brsunagad/visible-light-communication/Pictures/receiever_image.jpeg

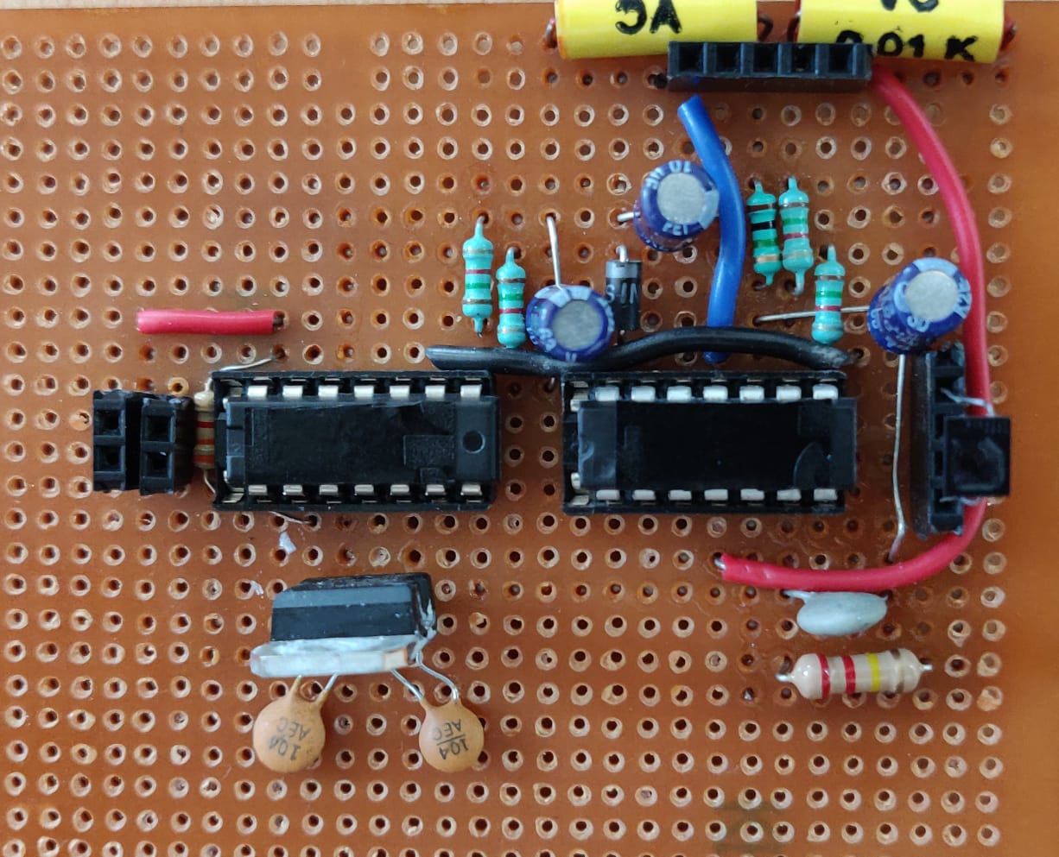
Pictures/receiever_image.jpeg
