brsunagad/visible-light-communication/Pictures/labeled_receiver.jpg

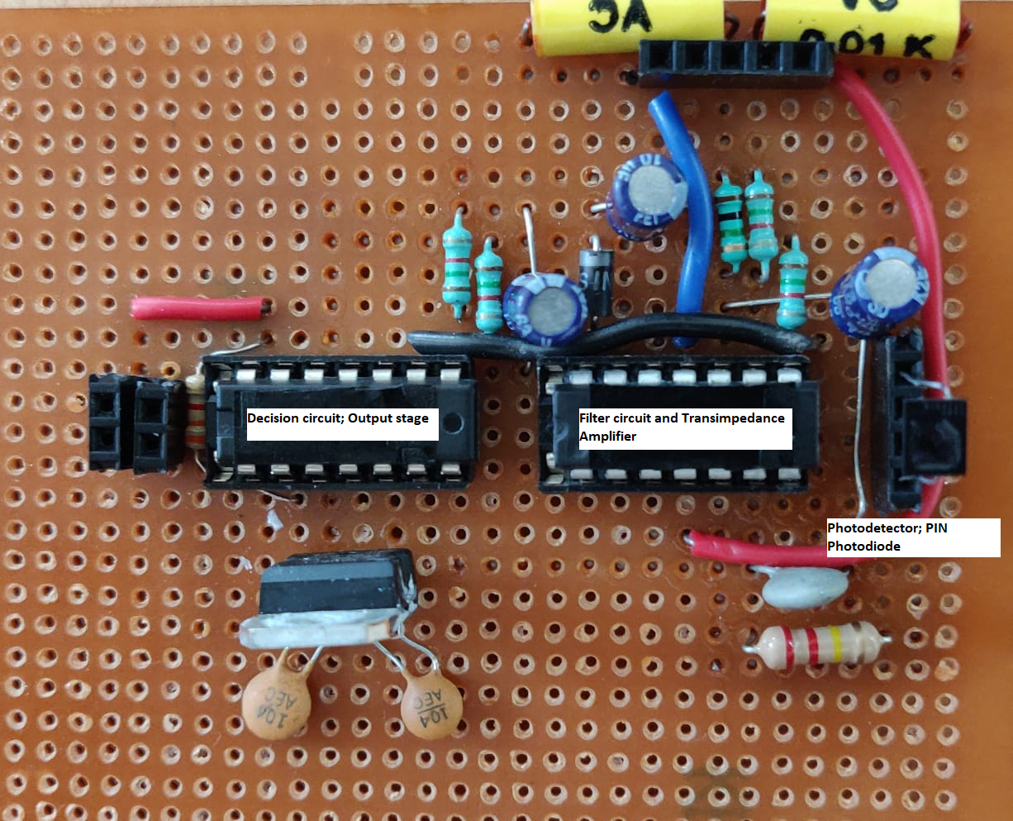
Pictures/labeled_receiver.jpg
