brsunagad/visible-light-communication/paper.pdf

IETE Journal of Research. | 1

Manav Gurumoorthy*

, Basavaraj R Sunagad$
, Ashwin Telagimathada Ravi#

, Akhilesh C Guddad^
and Rohini
Nagapadma&

Manav Gurumoorthy, Basavaraj R Sunagad, Ashwin Telagimathada Ravi and Akhilesh C Guddad are with the department of Electronics and Communication Engineering at The National Institute of Engineering, Mysuru. (* manav.gurumoorthy@gmail.com,

$
brsunagad@gmail.com ,
ashwintr303@gmail.com,
^
akhileshguddad@gmail.com )
Rohini Nagapadma is Professor in the department of Electronics and Communication Engineering at The National Institute of Engineering, Mysuru. (& rohini_nagapadma@nie.ac.in )

ABSTRACT
As conventional communication techniques are reaching its limit in terms of bandwidth, there is a need to explore ways which can overcome the limitations of the current communication techniques. In most cases, the limiting factor for high data rates tends to be the bandwidth of the system. Significant research efforts have been made towards eliminating this drawback of traditional systems while not causing any degradation in the quality of service. This has led to exploring the unused regions of the electromagnetic spectrum to make the switch from RF spectrum and its limited bandwidth. Visible light as a medium of communication is an ideal candidate due to its seemingly infinite bandwidth. Such a method of communication where visible light itself is a medium for data transfer is called Visible Light Communication (VLC). Our research demonstrates the same.

Keywords:
Analog frontend circuit, LED, LTSpice, Manchester encoding, Micro-controller, MOSFET, Photodiode, Serial communication, TIA, VLC.

### 1. INTRODUCTION

The visible light spectrum is the portion of the electromagnetic spectrum that is visible to the human eye. Electromagnetic radiation in this range of wavelengths is called visible light or simply light. A typical human eye will respond to wavelengths from about 390 to 700 nanometers. In terms of frequency, this corresponds to a band in the vicinity of 430–770 THz (Tera-hertz).
Visible light communication is a method of data transfer using visible light spectrum. The visible light spectrum has a bandwidth spanning 100s of THz which is 10000 times larger than the RF bandwidth.
VLC has numerous advantages over conventional methods, such as higher data rates, larger bandwidth, higher security, lower power consumption. Experiments done in VLC have achieved a data rate of 1Gbps under laboratory conditions. By using visible light, it is intended to achieve wireless communication in environments where it is not convenient to use Radio Frequency(RF) waves like in airplanes, hospitals etc. [4].
In VLC, the light source is typically a Light Emitting Diode (LED). Here LEDs are used for data transmission and offers illumination simultaneously. The main principle of this communication system is to switch ON and switch OFF a light source at a high rate, where the ON and OFF states of the light represent binary 1 and binary 0 respectively. By making the switching rate higher than the persistence of vision for humans, the light appears to be continuous in nature. Due to this continuous switching the overall brightness of the light decreases. The receiver works by looking out for the rapid changes of the light that represent data, thereby creating a line of sight communication link between the transmitter and the receiver.
VLC can potentially have a very large bandwidth but it is plagued by certain limitations owing to its physical components. At the transmitter, a white LED is used as a source of light. The limitation in bandwidth arises by the method in which the LED produces white light. At the receiver, the photodiode contains parasitic capacitances which limit the bandwidth of the VLC system. Ambient light interference introduces noise in the channel which affects system performance. The operating range is further limited by sensitivity of the photodiode.
Having studied and understood the capabilities and limitations behind this technology, our research attempts to build a functional visible light communication system to allow basic data transmission between two communicating nodes.

# Visible Light Communication Based File Delivery System

### 2.APPROACH

In our approach to implement a VLC system, we have established communication between two computers. The basic principle is that the transmitter side is made to drive an LED connected to one of the digital output pins of the arduino. The LED toggles ON and OFF based on the pulse received from the digital pin. The receiver uses a photodiode in reverse bias which produces current variations proportional to the received signal. These variations in current need to be further processed to obtain digital voltage signals that represent the data being transmitted.

### 2.1 Transmitter

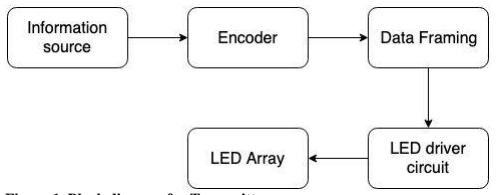
[picture p30: figure]

Figure 1. Block diagram for Transmitter.

2.1.1 Transmitter Software
For the transmitter, feeding in serialized data isn't an ideal way to send the data across the visible light channel. This is because typically data consists of HIGH (1) and LOW (0) bits in which the number of 0s maybe higher. This causes two problems: the first is that due to an increase in the number of transitions in the state of the led, there is a discernable flicker from the source which is not desirable; secondly, the overall brightness of the source drops below 50% as the time that the LED is ON is less than half of the total time. An encoding format is used to overcome the same. A modest way to encode the data is to use Manchester encoding, in which each data bit is encoded as a transition from low to high, or high to low, for an equal duration of time. Here a bit valued „1‟ is encoded as a signal going from HIGH state to LOW state and a „0‟ is encoded to a signal going from LOW state to HIGH state. The Manchester encoded data prevents the reception of consecutive 0s. As a result, the LED brightness is not adversely affected. The encoding scheme used also helps reduce flickering and it is not visible to the naked eye.
Since we use asynchronous serial communication, framing is essential for reliable communication. Framing typically involves the addition of two special flags called delimiters that are added to the start and the end of a data segment. In our implementation we have used 0x03 and 0x02 for the start and stop bits respectively. Additionally, asynchronous communication requires data synchronization between the sender and receiver and this is achieved by a synchronization byte 0xD5 [1].
In order to transfer files from a computer to the microcontroller, a software overlay is needed to read from the file and push the data onto the Arduino through an RS232 interface. Probing into the possible solutions has resulted in exploring multiple programming language options including

C++, python, java and C# and softwares including MATLAB, Processing and Microsoft Visual Studio. The selection of software depends on the trade-off between speed, efficiency and ease of use. While python offers diverse ready to use APIs, C++ promises speed and ease of bit manipulation. Similarly, reading various files from the computer proves to be easier on C# (run on Visual Studio) than on Processing (based on Java).

2.1.2 Transmitter Hardware
The principle of data transmission in VLC is to turn ON and turn OFF a light source in correspondence to the transmitted bits. The transmitter in our system consists of a high power white LED (12 Watts) and a MOSFET switch. This is interfaced to a computer (data source) using an Arduino Uno board that provides the RS-232 interface. Data from the computer is sent to the arduino through UART where it is processed and encoded. The processed data is sent to the driver circuit through a digital output pin in the form of bits.

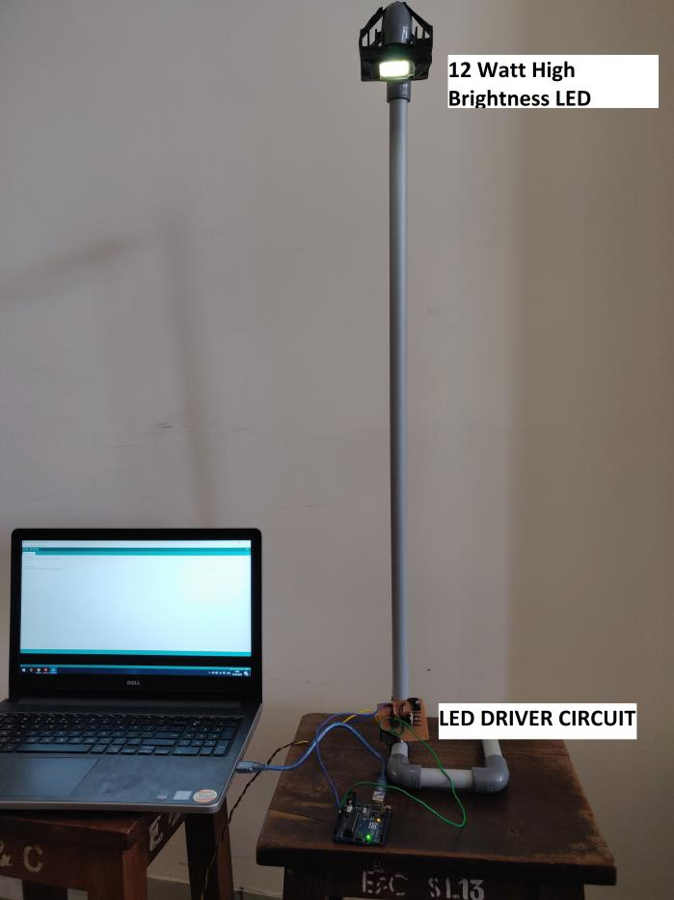
[picture p31: figure]

Figure 2. Experimental setup of Transmitter; the setup consists of High Power LED source, LED driver circuit and micro-controller.

### 2.2 Receiver

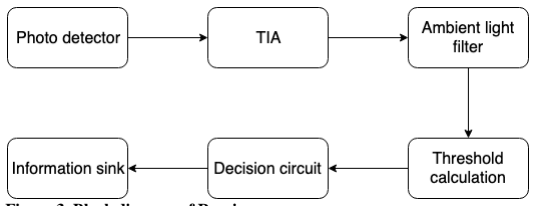
[picture p32: figure]

Figure 3. Block diagram of Receiver

2.2.1 Receiver Software
The digital signals from the receiver front end circuit are read by the digital pins of the Arduino. The signal being a digital PWM wave, it is necessary to identify the rising and falling edges of the signal to differentiate HIGH (1) and LOW
(0) levels to convert the digital signals into a bit stream. To achieve this, the received digital signals are sampled at an appropriate frequency and a symbol period is calculated. If the signal is found to be steady for longer than a single symbol period, the data is considered valid and the receiver starts receiving.
The continuous stream of alternating 1s and 0s sent by the transmitter to keep the LED ON is ignored and the receiver only starts reading data when it encounters a synchronization byte. The receiver then removes the start delimiter and extracts data until the stop delimiter is reached. The buffer limit of 64 bytes on an Arduino board is hard coded into its firmware source code. Larger data sent to through the buffer gets truncated, thus imposing a limiting factor on the size of each frame.
The data extracted from each frame is decoded from its Manchester form and coalesced into groups of 8 bits which represents a character. The Arduino then outputs the string of characters to the computer through its communication port.

2.2.2 Receiver Hardware
At the receiving end, the photo-sensing element used is a PIN Photodiode which can sense high frequency variations in the intensity of light being transmitted. The photodiode produces electric current which is proportional to the intensity of light incident on it. This electric current is in the order of few micro-amperes and analog in nature. The microcontroller can only recognize digital voltage levels which necessitate the need for a frontend processing circuit.
The frontend processing circuit should be able to convert electric current to equivalent voltage levels, filter the ambient interference, calculate a reference and output the digital signals.
To decide on efficient receiver hardware, we have simulated and tested the following frontend circuits: DC restoration circuit [7], AC coupled circuit and AC amplifier circuit. After a thorough analysis of simulation results we have concluded that the AC coupled circuit is more reliable and efficient.

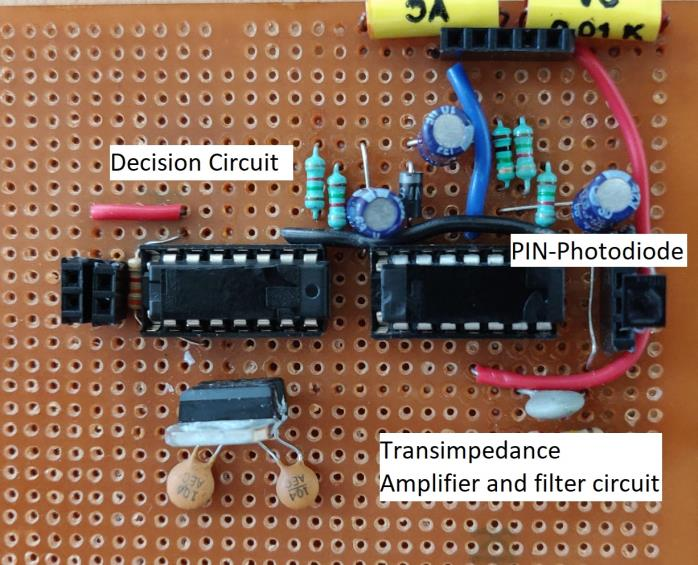
[picture p33: figure]

Figure 4. Frontend signal processing circuit for receiver; consists of PIN Photodiode as photo-detector, TIA stage, filter stage and decision stage. This circuit eliminates the need for a conventional ADC.

The first stage in the processing circuit is a Trans-Impedance Amplifier (TIA) which converts electric current into voltage levels. The design of TIA is very crucial as it sets the upper limit of bandwidth. It also plays a significant role in reducing the effects of junction capacitance of the photodiode. Second stage involves removal of ambient light interference. The ambient light produces a DC shift in the received signal which is eliminated by AC coupling. Third stage involves calculation of a suitable voltage level which is set as reference for the comparator. Last stage is the digitization of voltage levels which is achieved by using a comparator. The comparator compares signals from second stage with the reference and outputs digital voltage levels to be read by the micro-controller.

### 3. RESULTS AND OBSERVATIONS

The proposed system is capable of taking either a string or a text file as input. The data is then encoded and framed using the above mentioned frame format. The frames are fed bitwise to the LED driver circuit. The system is tested for reliable performance at a communication speed of 600bps with the transmitter and receiver separated by a distance of 6ft.
Initially, the receiver used the inbuilt Arduino ADC instead of a frontend circuit for signal conversion. Although the system was simple and reliable, the computationally intensive 10-bit ADC consumed more number of clock cycles and slowed down the communication speed. To overcome this limitation, the above mentioned receiver circuit was built and implemented.

### 3.1 Simulation of frontend circuit

Before realizing the frontend receiver hardware, an LTSpice model of the circuit was built and analyzed. Simulation was tested based on scenarios that the system was expected to encounter such as ambient light interference. The expected DC shift from the ambient light was seen at the output of the TIA. The filter stages and decision circuitry performed as designed and removed this shift to yield a near perfect digital signal as shown in Figure 5.

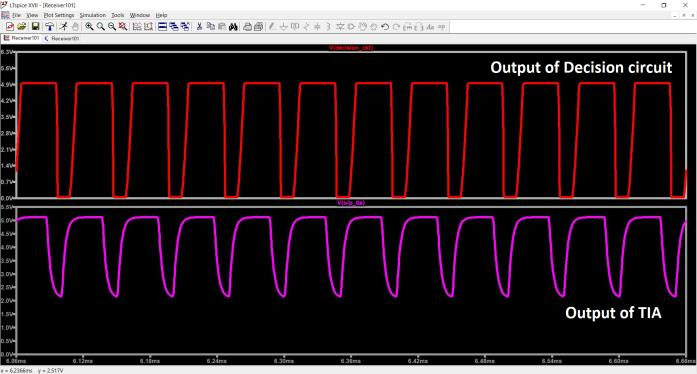
[picture p34: figure]

Figure 5. Simulation results of the frontend circuitry. Lower waveform shows the output of the TIA, with the DC shift from the ambient light interference. Upper waveform is the final expected output of the circuit.

### 3.2 Comparison of Simulation with Actual Results

The receiver frontend circuit was tested under various ambient lighting conditions. It was also tested at different separations and misalignments and was found to be reliable with no data loss or corruption.

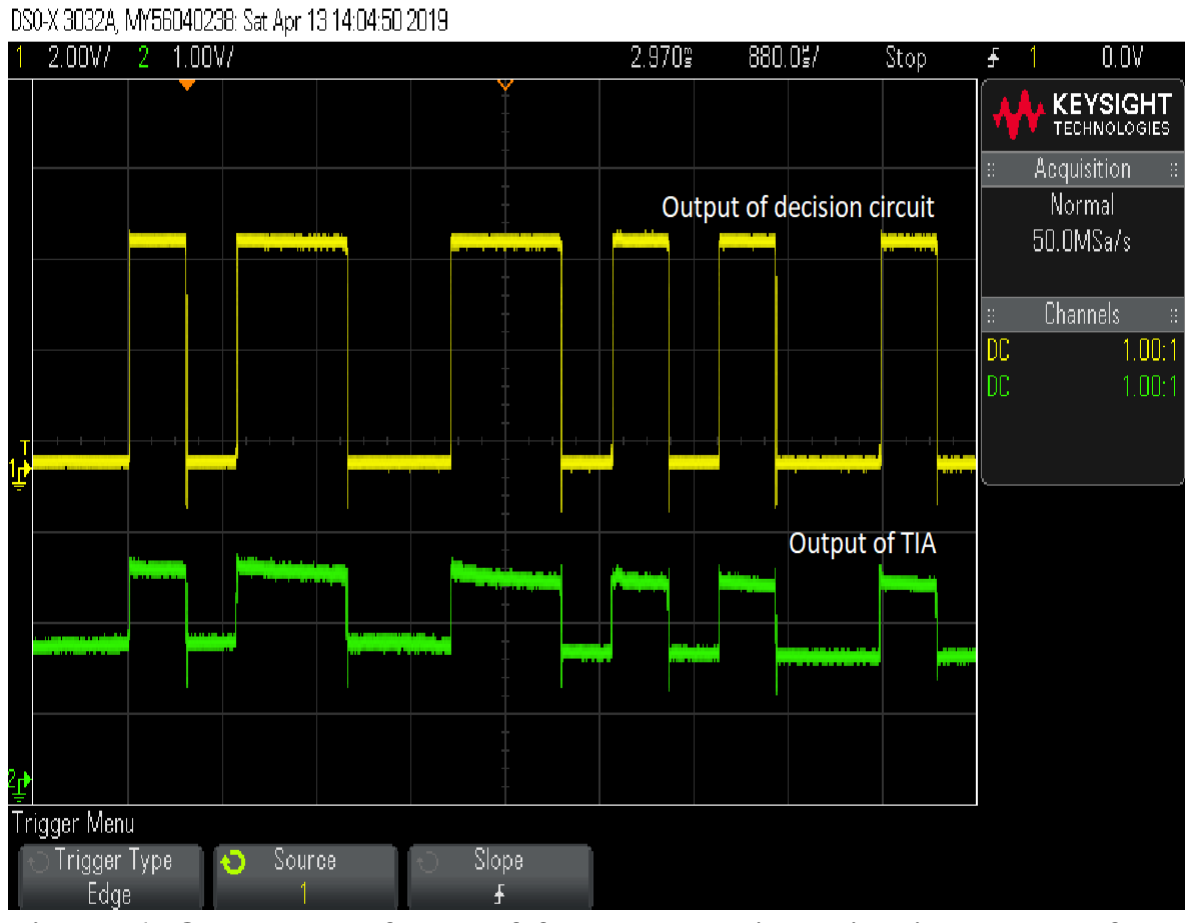
[picture p35: figure]

Figure 6. Output waveforms of frontend receiver circuit; top waveform indicating output of TIA and bottom waveform indicating output of decision circuit.

In Figure 6, we can see that the output of TIA is an analog signal with a DC shift of 1.5 volts. This signal is filtered and fed to the decision circuit whose output is represented by the upper waveform. We found that the actual results met the expectation set by the simulations.

### 4. LIMITATIONS

Though ideally it seems that VLC has a very large bandwidth it has its own limitations. Its bandwidth is limited by the typical elements involved which are LEDs and Photodiodes. At transmitter side a white LED is used as a source of light, the limitation in bandwidth arises by the method in which a LED produces white light.
White light is a mixture of Red, Green and Blue light. The RGB white method produces white light by combining the output from red, green and blue LEDs. This is an additive color method. But RGB white light is hardware-intensive, since it requires three LEDs, and it tends to render pastel colors unnaturally, a fact which is largely responsible for the poor color rendering index of RGB white light. The Phosphor white method produces white light in a single LED by combining a short wavelength LED such as blue or UV, and a yellow phosphor coating [6]. It is seen that the bandwidth is ~2MHz for the white, and ~10MHz for the blue component only [2]. This is due to the long decay time of the phosphor, and provides a limitation on the overall bandwidth available. In addition, the Blue LED die is not designed for high speed operation and is very large in area (and thus has high equivalent capacitance) compared with devices used for high speed communications. The limited bandwidth of the LEDs is therefore one of the major challenges for high-speed communications.
At the receiver, studying a model of the photodiode led to the discovery of a junction capacitance which adversely affects the bandwidth of the VLC system. Ambient light interference introduces noise in the channel which if large enough, saturates the photodiode current. The operating range is also limited by the sensitivity of the photodiode. Factors limiting the performance of the photodiode are the capacitance of the junction as well as the parasitic capacitance of the package. The reverse-biased PIN junction acts like a capacitor because charge can be stored in the P and N sides with the depletion layer acting as a dielectric. This junction capacitance is to be minimized by careful design of the diode structure for high speed performance. Most practical high speed diodes typically have sub Pico-farad capacitances. Minimizing the load resistance also improves the performance of the receiver as a whole but it is not a limitation of the diode itself, but is related to the receiver‟s electrical design.
The transmitter circuit uses ON OFF Keying (OOK) to modulate the light source at a high frequency. However, OOK is more sensitive to additive noise, has a poor spectral efficiency and power efficiency. The Manchester encoding used having an equal number of ones and zeros offers only 50% efficiency.

### 5. FUTURE WORK

VLC requires the light source to be always ON. A robust transmitter can be designed which is capable of adapting it‟s brightness by varying the intensity based on received signal strength and ambient conditions. A better substitution for Manchester encoding which has more number of 1s can increase the efficiency and also keep the light source ON for a longer duration. Alternate modulation schemes such as FSK and BPSK which provide better immunity to noise can be implemented. To obtain gigabit speeds and parallel transmissions, OFDM and optical MIMO techniques can be used [2].
In spite of having a robust receiver, there might be few errors in the data received. Hence performance of code has to be improved. This can be done by using better encoding techniques and including data bits for error correction. Multiple photo detectors can be used in parallel to increase the current generated, thereby increasing the transmission distance. Solar panel has a very large surface area compared to a photodiode; hence they receive large optical power. They also receive illumination from ambient light; the DC offset produced by ambient light in photodiodes being small cannot be harnessed but in solar cells the DC offset is large enough to be harvested. In this way a self-sustained receiver can be developed [5].

### 6. APPLICATIONS

VLC has the following implicit characteristics including high bandwidth, low power consumption, inherent security and non-licensed channels that have made it beneficial for practical use. Diverse application scenarios are as follows: Every modern day vehicle embodies LED headlights which can be used to implement VLC modules. Applications in this space include collision warning, lane change warning, traffic rule violation warning and pre-accident sensing. Devices and machines sensitive to electromagnetic interference (such as MRI scanners) can switch to VLC technology in hospitals to prevent interference with radio waves from other machines. Large volumes of data can be transferred with adequate security by establishing a connection between two mobiles pointed at each other. VLC can provide much higher data transfer rates than Wi-Fi or Bluetooth. VLC can be incorporated in passenger compartments of aircraft where radio is undesirable. LEDs in the cabin can also be used to provide multimedia streaming services and flight tracking details to passengers. RF signals do not work underwater. VLC devices can be used for short distance communication underwater between divers or submarines and the surface.

### 7. CONCLUSION

In this approach we see how a common light source such as an LED can be made to transmit data in a more efficient way than conventional methods. We are surrounded by numerous light sources, we hope that someday all those sources can be made to give dual functionality i.e. to perform as both a light as well as a data source with minimal modifications. Thus, scaling this technology globally is not a tedious task. We propose to develop an Integrated Chip (IC) that can be attached to existing light bulbs in order to make them a VLC transmitter. It is predicted that VLC could play a vital role in broadcast communication. In terms of security of data being transmitted, tapping the source is not a possibility. In our work in this field, having realized the implications that this technology would have in the way we communicate, we believe that this could revolutionize wireless communication.

ACKNOWLEDGMENT

The authors would like to thank Dr. Rohini Nagapadma, Head of the Department, ECE, The National Institute of Engineering Mysore, for her continuous support and insights throughout the duration of the project.

REFERENCES

1. Piat | Jonathan, | Arduino simple Visible Light
Communication,
https://github.com/jpiat/arduino/wiki/Arduino-simple-Visible-LightCommunication (https://github.com/jpiat/arduino/wiki/Arduino-simple-Visible-LightCommunication)
2. D. C. O‟Brien, L. Zeng, H. Le-Minh, G. Faulkner, J.
W. Wa lewski, and S. Randel, Personal, Indoor and Mobile Radio Communications, 2008. PIMRC 2008. IEEE 19th International Symposium on, 2008. “Visible light communications: Challenges and possibilities,” 2008.
3. A. E. Kelly, J. J. D. McKendry, S. Zhang, D. Massoubre, B. R. Rae, R. P. Green, R. K. Henderson, and M. D. Dawson, "High -speed GaN micro-LED arrays for data communications," in Transparent Optical Networks (ICTON), 2012 14th International Conference on, 2012, pp. 15.
4. H. Haas and C. Chen, European Conference on Optical Communication (ECOC), What is LiFi?, 2015
5. Zixiong Wang, Dobroslav Tsonev, Stefan Videv, and Harald Haas, IEEE journal on selected areas in communications, VOL. 33, NO. 8, AUGUST 2015, ”On the design of a solar panel receiver for Optical Wireless Communication and simultaneous energy harvesting”, 2015
6. Photon Star Technology Ltd., “How LEDs produce white light”
http://www.photonstartechnology.com/learn/how_leds_produce_white_light (http://www.photonstartechnology.com/learn/how_leds_produce_white_light)
7. Bonnie | Baker, | “Photo | sensing | with | ambient
background”, February 17 2011. https://www.edn.com/Pdf/ViewPdf?contentItemId=43 64018 (https://www.edn.com/Pdf/ViewPdf?contentItemId=4364018)

Manav | Gurumoorthy | is | an

### undergraduate student, currently in his final semester in the department of Electronics and Communication at NIE, Mysore. He is currently working on further developments in the field of Visible Light Communication as a part of his

undergraduate thesis.

Basavaraj | R | Sunagad | is an

### undergraduate student, currently in his final semester in the department of Electronics and Communication at NIE, Mysore. He is currently working on further developments in the field of Visible Light Communication as a part of

his undergraduate thesis.

Ashwin Telagimathada Ravi is an

### undergraduate student, currently in his final semester in the department of Electronics and Communication at NIE, Mysore. He is currently working on further developments in the field of Visible Light Communication as a part of

his undergraduate thesis.

Akhilesh | C | Guddad | is | an

### undergraduate student, currently in his final semester in the department of Electronics and Communication at NIE, Mysore. He is currently working on further developments in the field of Visible Light Communication as a part of

his undergraduate thesis.

Dr. | Rohini | Nagapadma | is
Professor | and | Head | of | the
Department | of | Electronics | &

### Communication Engineering. She

has received her Ph.D. from VTU,

### M.Tech from IIT, Madras and M.E.M. and B.E. from University of Mysore. Her research interests are in the areas of Image

### Processing and Multimedia. Special Interest has been shown in the area of image compression when working towards PhD. She is teaching both undergraduate and postgraduate students and

handles subjects like Telecommunication Switching, Signals and Systems, Wireless Communication, DSP, Image processing and Multimedia.
