brsunagad/visible-light-communication/circuit diagrams/rx.png

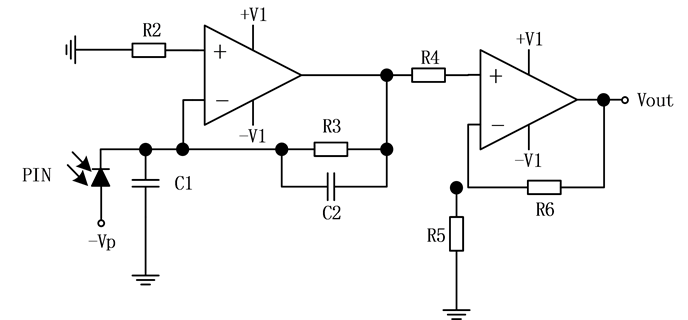
circuit diagrams/rx.png
